John-Lluch/G6A-RISC/README.md

# G6A-RISC
G6A-RISC Relay based computer
