John-Lluch/G6A-RISC/Docs/OmronRelay/G6A-274.pdf

●Maximum Switching Power | ●Durability

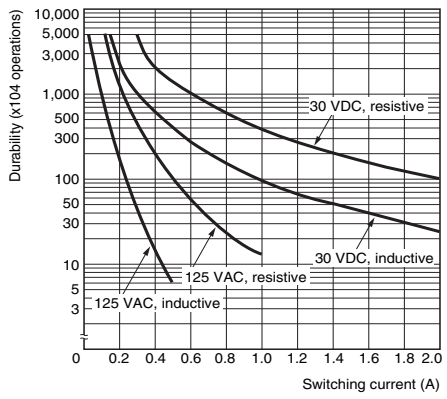
[picture p1: figure]
Durability (x104 operations); Switching current (A); 125 VAC, resistive; 125 VAC, inductive; 30 VDC, inductive; 30 VDC, resistive

0 | 0.2 0.4 0.6 0.8 1.0 1.2 1.4 1.6 1.8 2.0
