John-Lluch/G6A-RISC/Docs/OmronRelay/G6A-274_.pdf

●Electrical Durability Test *1 | ●Contact Reliability Test *1, *2

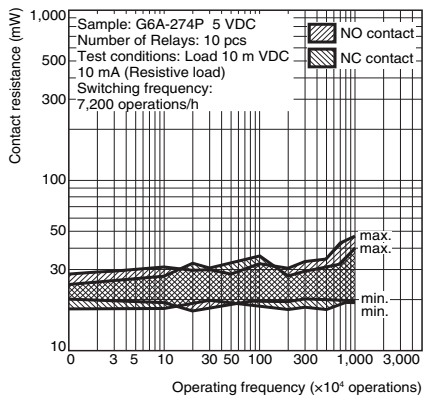
[picture p2: figure]
NO contact; NC contact; Sample: G6A-274P; 5 VDC; Number of Relays: 10 pcs Test conditions: Load 10 m VDC 10 mA (Resistive load) Switching frequency: 7,200 operations/h; max.; min.; Operating frequency (×10⁴; operations); Contact resistance (mW)
