John-Lluch/G6A-RISC/Docs/LogisimDocs/Buffer1.pdf

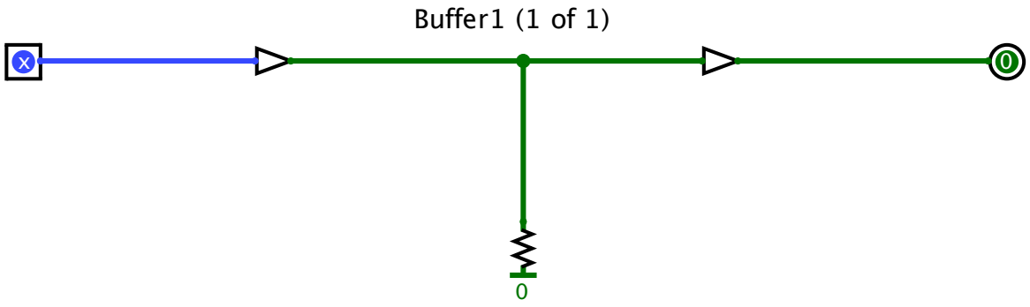
[picture p3: figure]
Buffer1 (1 of 1)
