John-Lluch/G6A-RISC/Docs/LogisimDocs/INCBase1.pdf

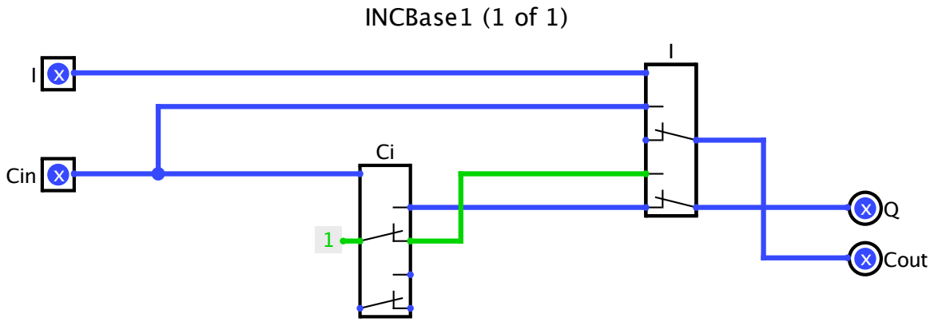
[picture p4: figure]
INCBase1 (1 of 1); Cin; x Cout
