John-Lluch/G6A-RISC/Docs/OmronRelay/G6A-274.png

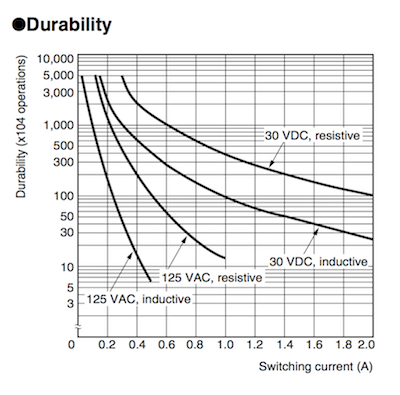
Docs/OmronRelay/G6A-274.png
