John-Lluch/G6A-RISC/Docs/OmronRelay/G6A-274_.png

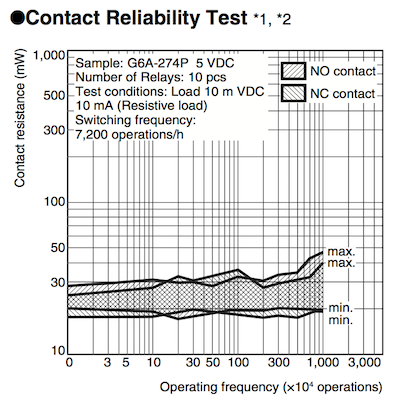
Docs/OmronRelay/G6A-274_.png
