John-Lluch/G6A-RISC/Docs/Sequencer.png

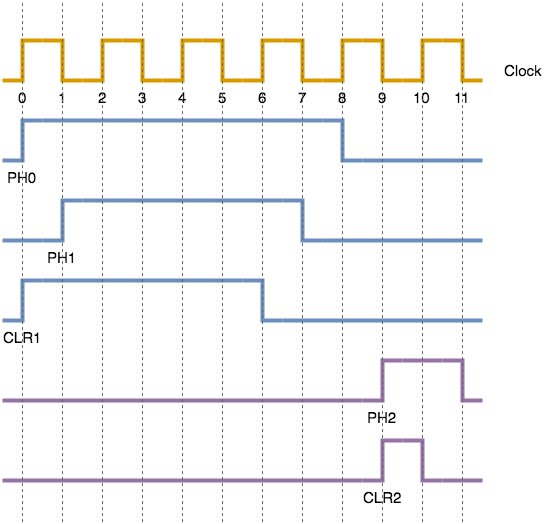
Docs/Sequencer.png
