John-Lluch/G6A-RISC/Docs/LogisimDocs/ALUFlags.pdf

# ALUFlags (1 of 1)

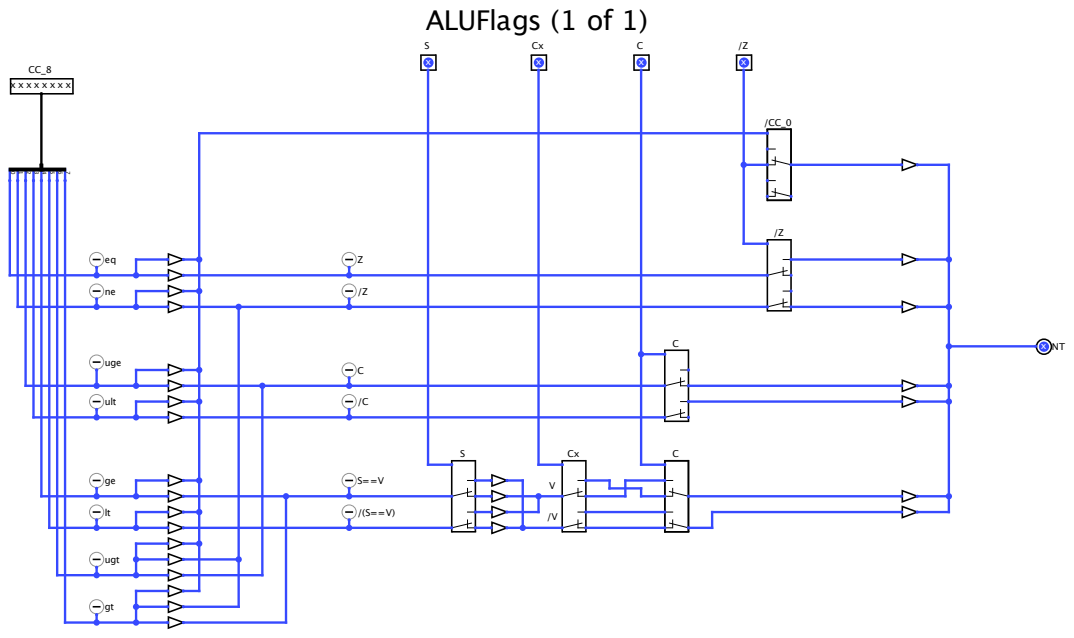
[picture p8: page 1]
ugt; ult; uge
