John-Lluch/G6A-RISC/Docs/LogisimDocs/ALU16Bit.pdf

# ALU16Bit (1 of 1)

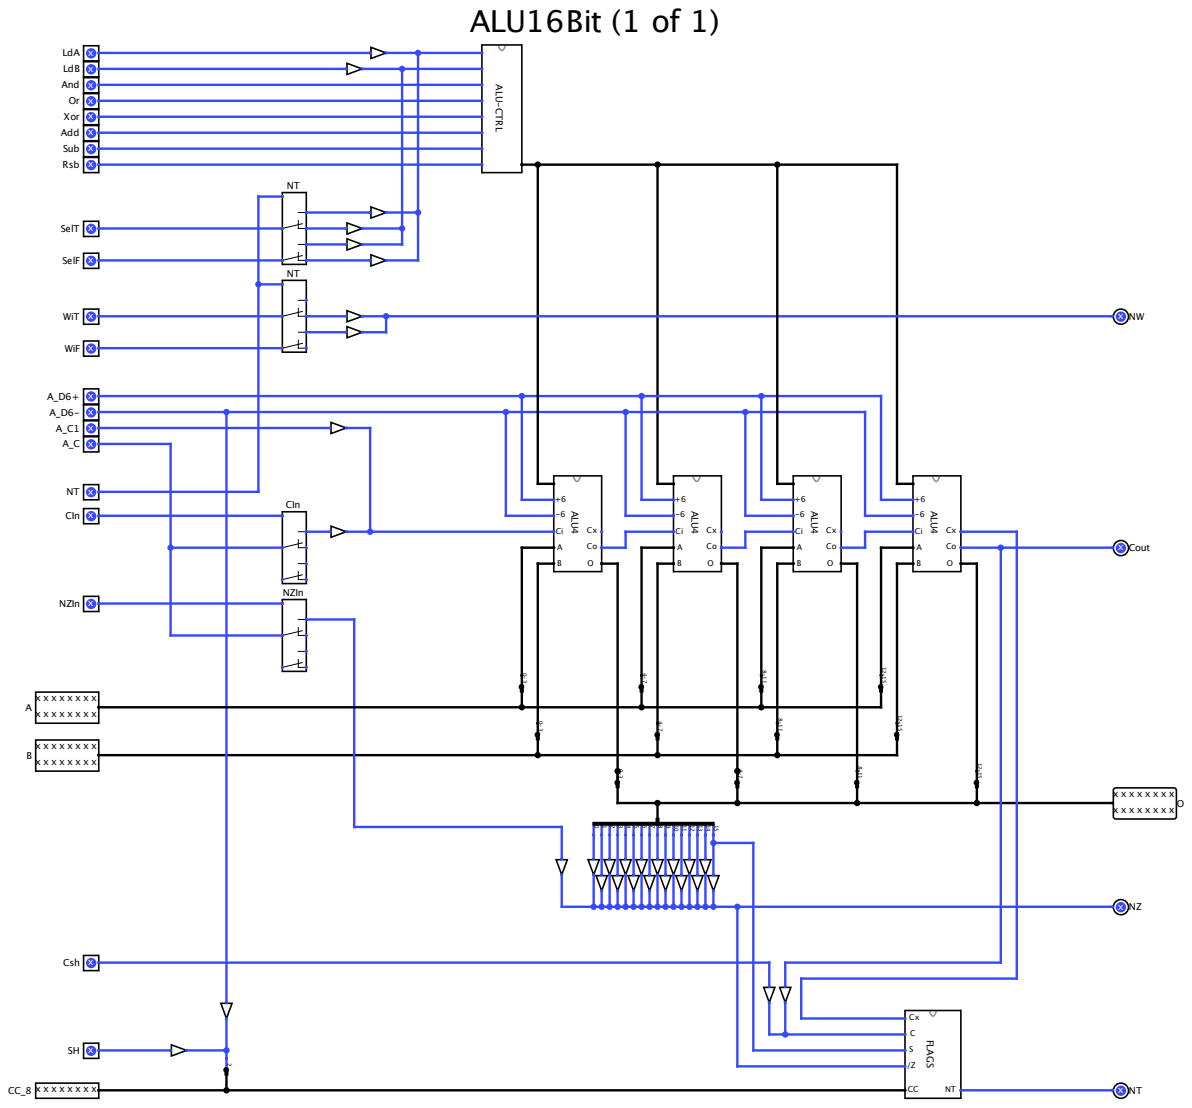
[picture p9: page 1]
Add; SelT; SelF; ALU4; FLAGS; Sub; WiT; CIn; ALU-CTRL; NZIn; x Cout; Csh; WiF; Rsb; LdB; And; LdA; Xor
