John-Lluch/G6A-RISC/Docs/LogisimDocs/InstDecoder.pdf

# InstDecoder (1 of 1)

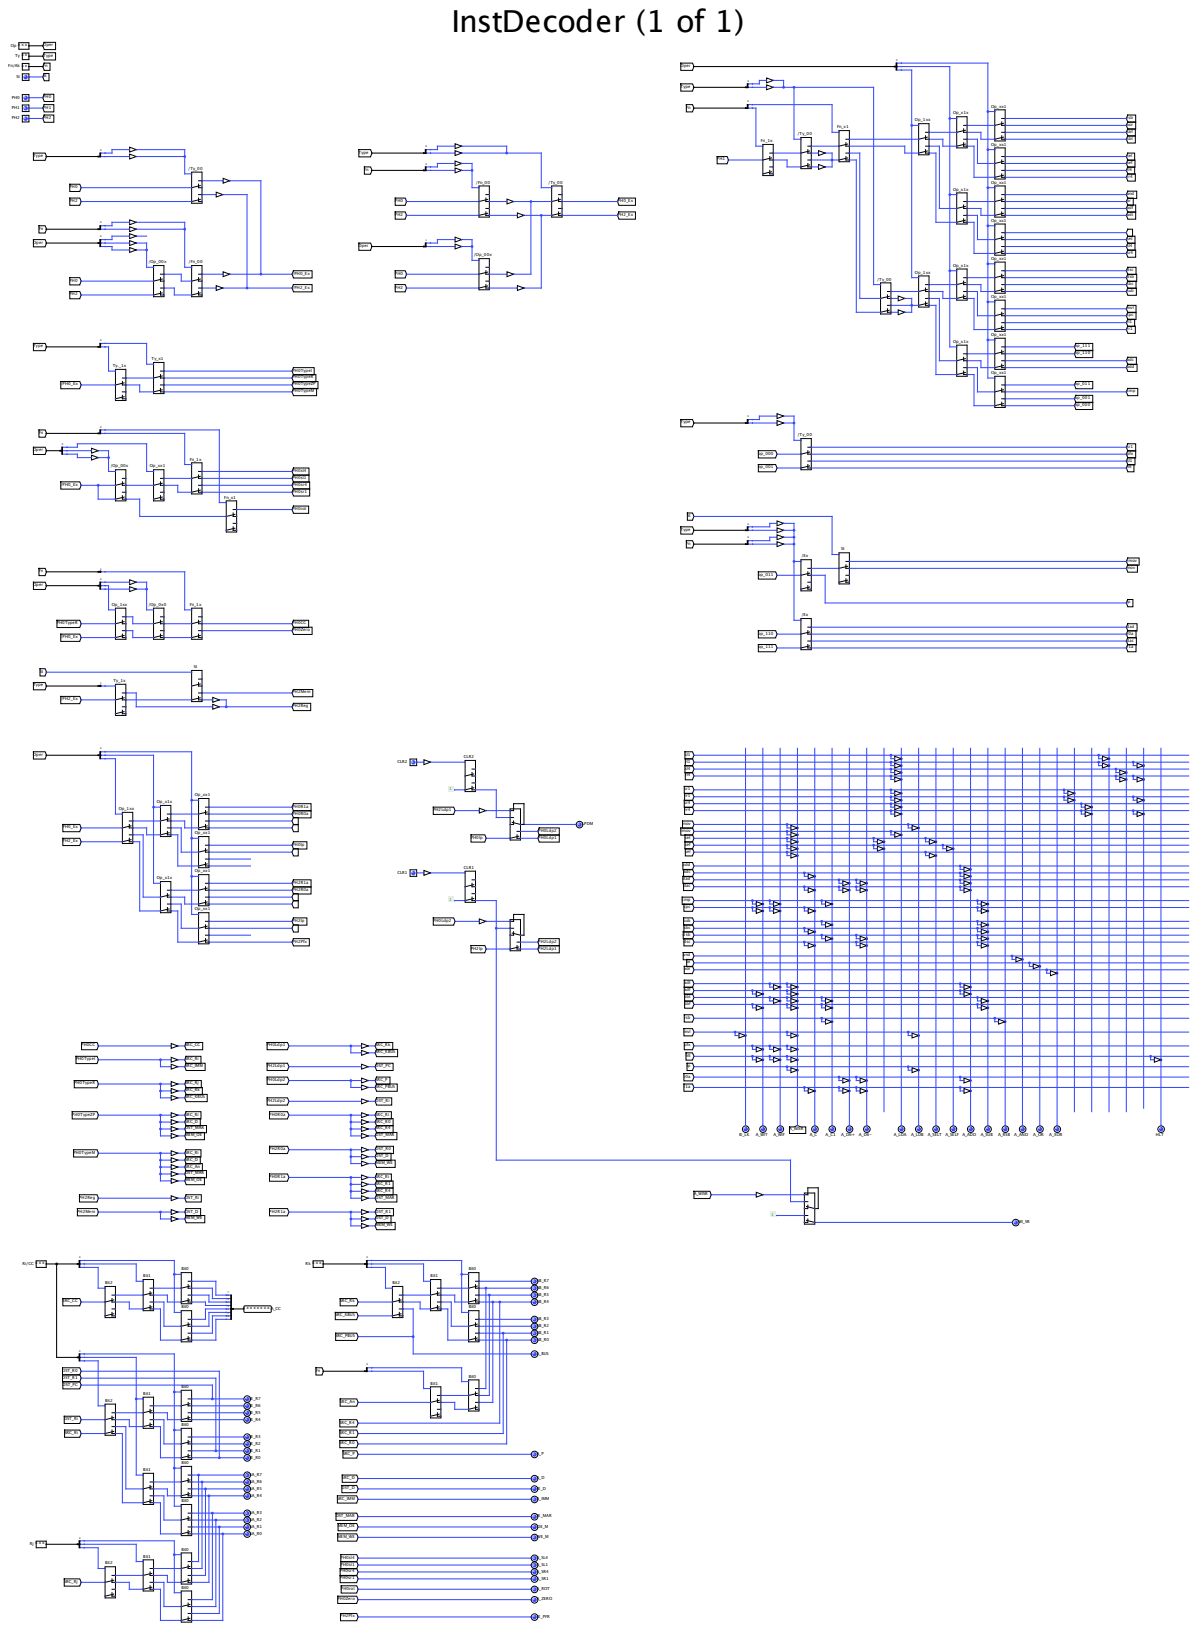
[picture p10: page 1]
Type; Bit2; Bit1; DST_Ri; sub; SRC_R0; Bit0; mvl; rmov; DST_MAR; PH0Zero; and; A_ADD; PH2Ldp2; rsb; add; A_WISR; PH0rot; PH0Ldp2; MEM_WE; dsc; DST_R0; CLR1 x; SRC_Ri; pfx; SRC_D; dsb; PH2Pfx; adf; SRC_Rk; x S_BUS; SRC_IMM; DST_PC; A_RSB; x LPDM; adc; sel; SRC_P; dac; SRC_CC; CLR2 x; SRC_R1; PH0TypeI; PH2Mem; x IE_PFR; PH2Ldp1; PH0TypeR; sbc; cmp; hlt; cpc; SRC_An; PH0TypeZP; adt; x IE_MAR; PH0TypeM; DST_D; SRC_PBUS; SRC_R4; Oper; x S_ZERO; x S_ROT; xor; DST_R1; CLR1; A_LDA; dad; PH0Ldp1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
