John-Lluch/G6A-RISC/Docs/LogisimDocs/ALUBase1Bit.pdf

## ALUBase1Bit (1 of 1)

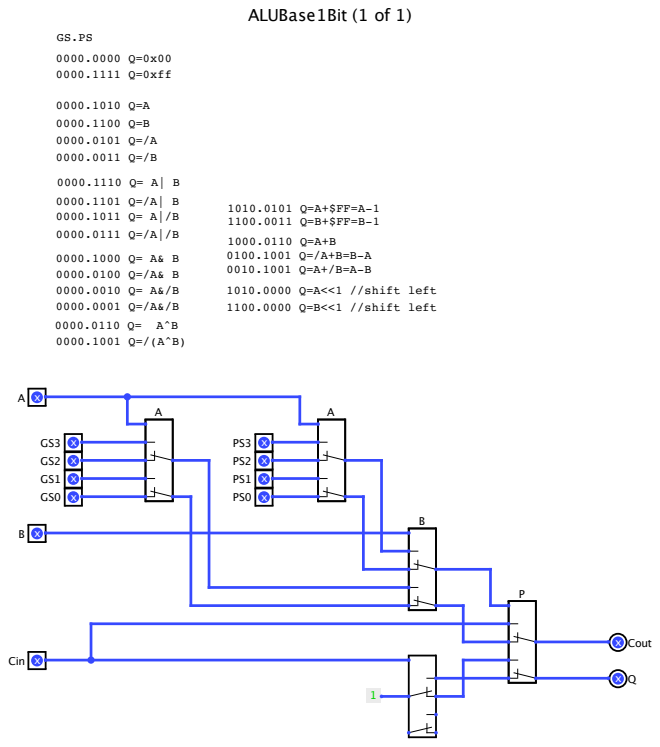
[picture p11: page 1]
0000.1111 Q=0xff; 1100.0000 Q=B<<1 //shift left; Cin; 1010.0000 Q=A<<1 //shift left; x Cout
