John-Lluch/G6A-RISC/Docs/LogisimDocs/ALUBase4Bit.pdf

ALUBase4Bit (1 of 1) Op | x x x x x x x x | ALU-1 | ALU-1

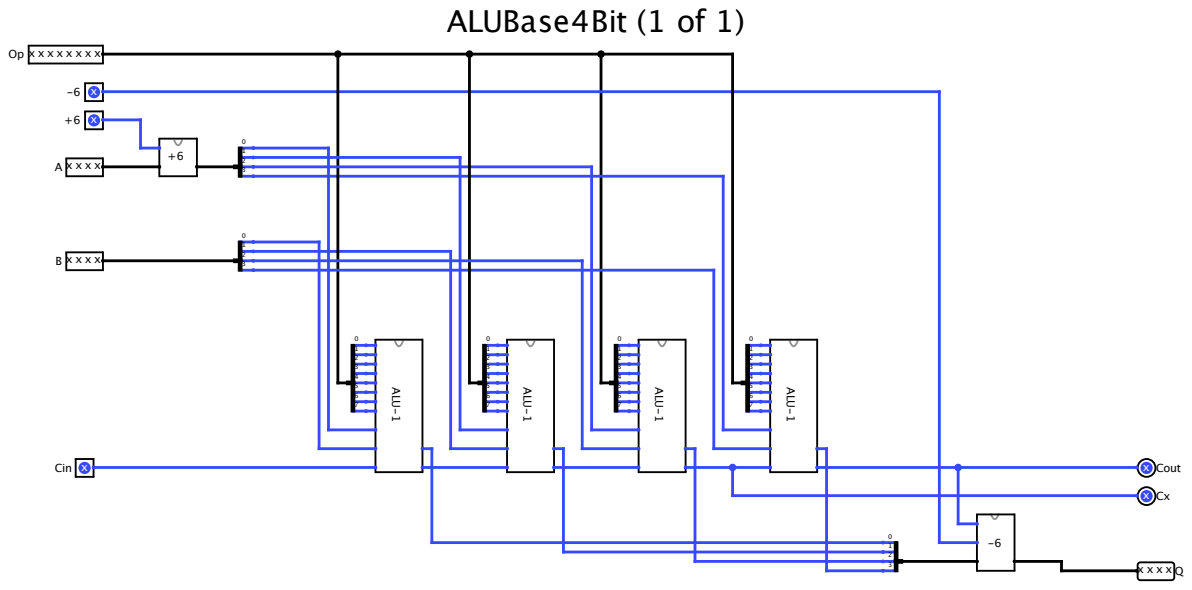
[picture p12: page 1]
ALU-1; Cin; x Cout
