John-Lluch/G6A-RISC/Docs/LogisimDocs/ALUSub6.pdf

ALUSub6 (1 of 1) | 0

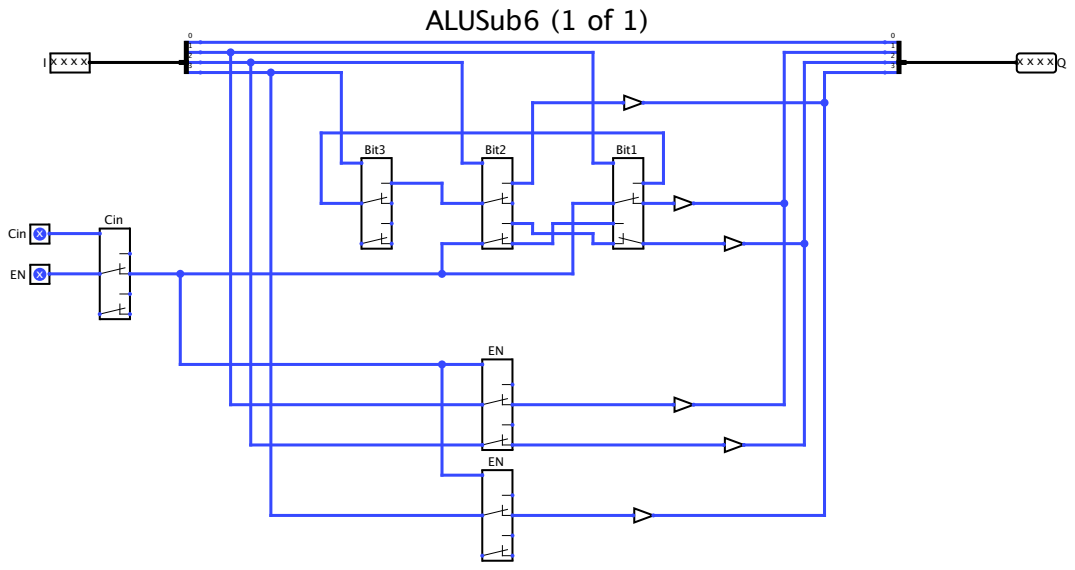
[picture p13: page 1]
Bit1; Cin; Bit3; Bit2
