John-Lluch/G6A-RISC/Docs/LogisimDocs/Main.pdf

# Main (1 of 1)

# R Out ALU REG ALUR

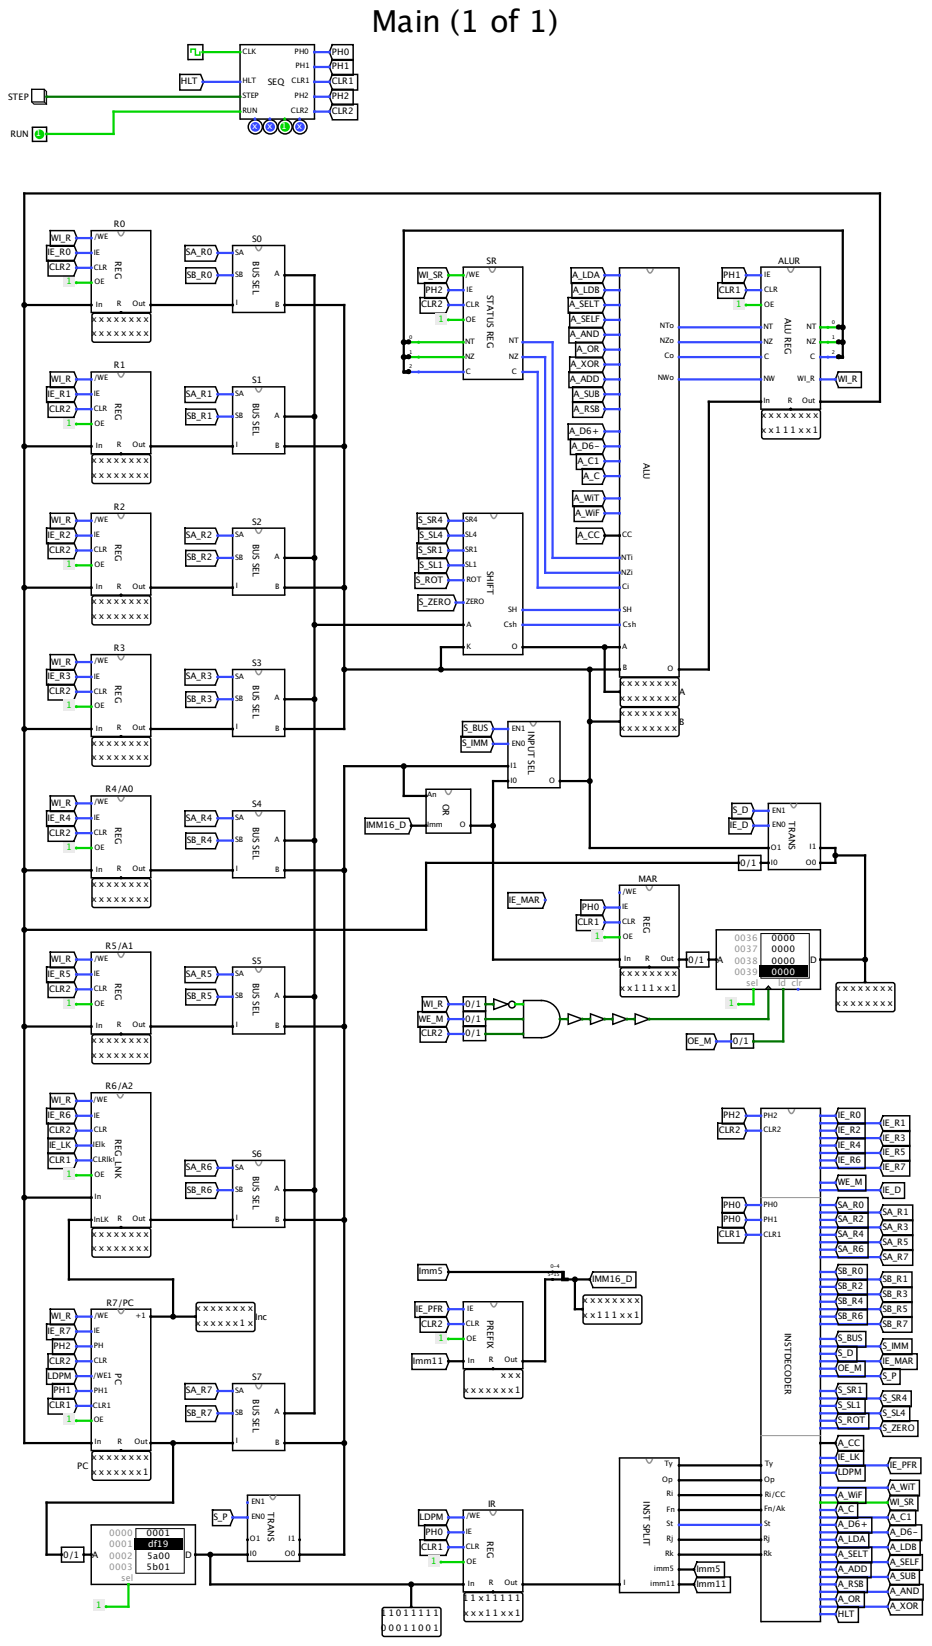
[picture p14: page 1]
HLT; CLR2; Csh; ZERO; ROT; SHIFT; IE_MAR; Imm5; BUS SEL S5; imm5; imm11; INST SPLIT; A_LDA; A_SUB; CLR1; sel; ld clr; O0 TRANS; Imm11; A_AND; S_ROT; A_WiT; RUN; A_SELT; LDPM; BUS SEL S0; S_IMM; A_XOR; STEP; CLR; Out; REG; REG R0; NZo; NZi; NTo; NTi; NWo; ALU; Imm; REG R1; REG R2; REG MAR; InLK; CLRlk; IElk; REG_LNK; A_WiF; A_ADD; Inc x x x x x x1 x; PREFIX; A_RSB; S_ZERO; A_SELF; A_LDB; BUS SEL S7; BUS SEL S1; BUS SEL S2; IE_PFR; STATUS REG SR; INPUT SEL; REG IR; BUS SEL S3; BUS SEL S6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
