John-Lluch/G6A-RISC/Docs/LogisimDocs/ADD16.pdf

# ADD16 (1 of 1)

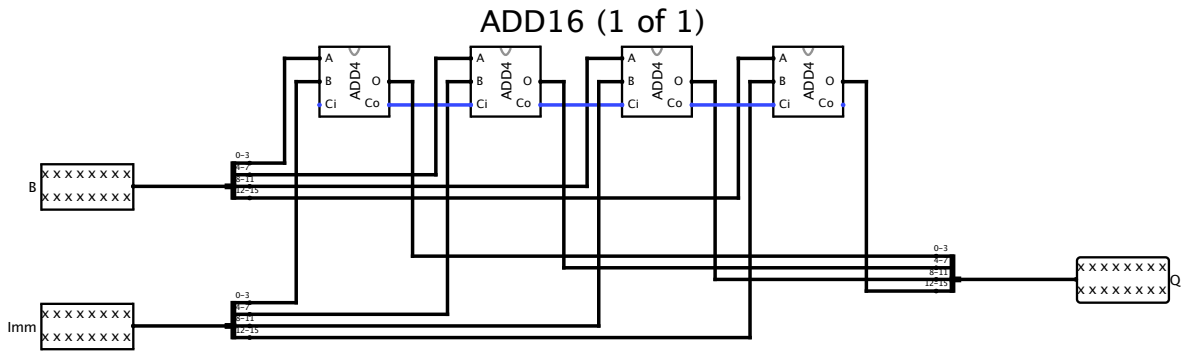
[picture p15: page 1]
Imm; Co ADD⁴

8-11
12-15

4-7
