John-Lluch/G6A-RISC/Docs/LogisimDocs/ADDBase1Bit.pdf

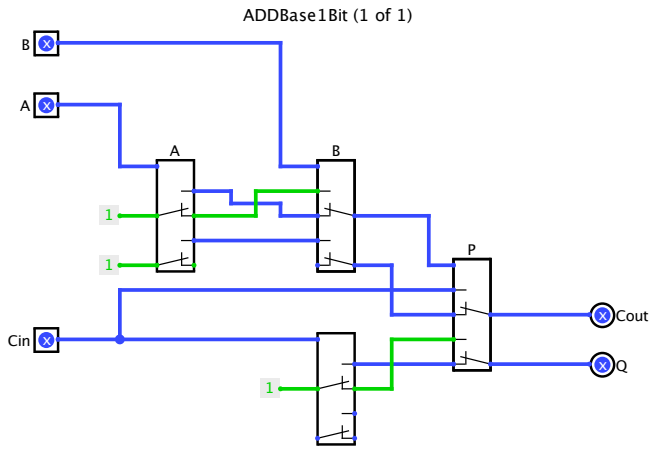
[picture p16: page 1]
ADDBase1Bit (1 of 1); Cin; x Cout
