John-Lluch/G6A-RISC/Docs/LogisimDocs/ALUAdd6.pdf

# ALUAdd6 (1 of 1)

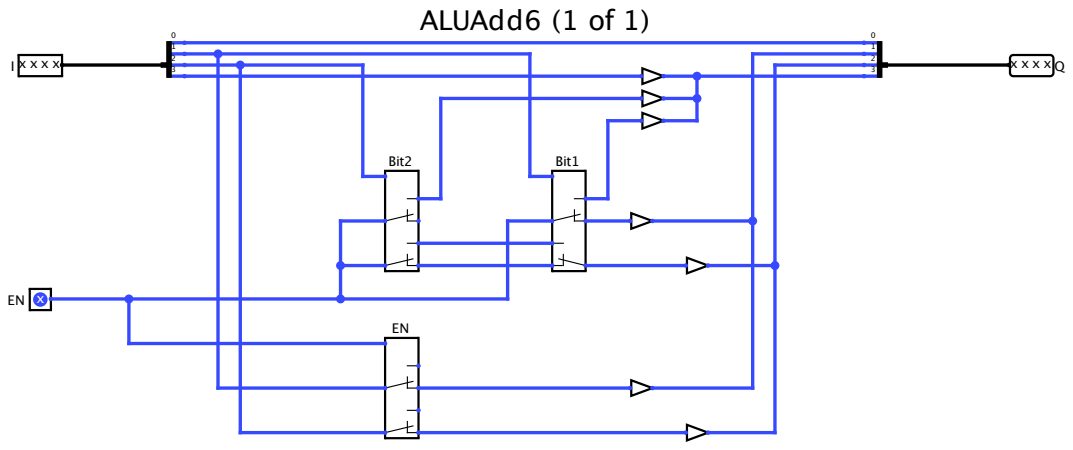
[picture p17: page 1]
Bit2; Bit1
