John-Lluch/G6A-RISC/Docs/LogisimDocs/ALUController.pdf

# ALUController (1 of 1)

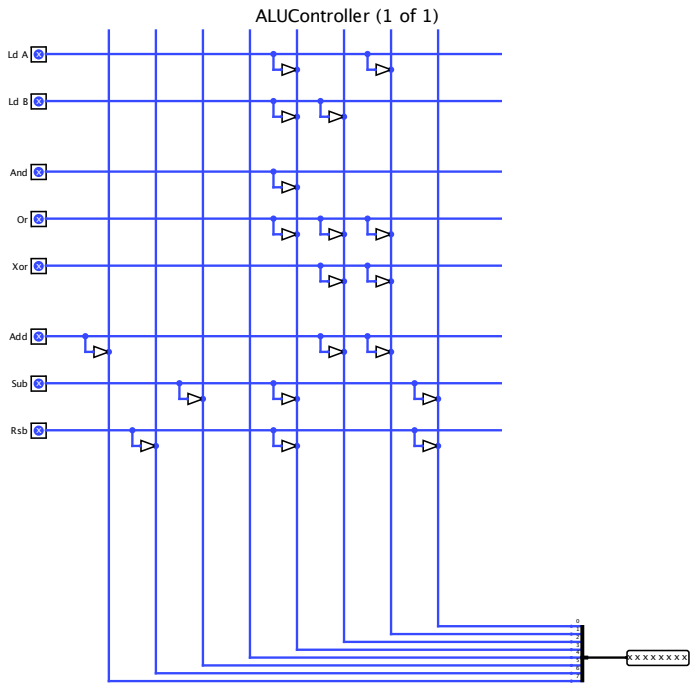
[picture p18: page 1]
Add; Sub; And; Rsb; Xor
