John-Lluch/G6A-RISC/Docs/LogisimDocs/Buffer16.pdf

## Buffer16 (1 of 1)

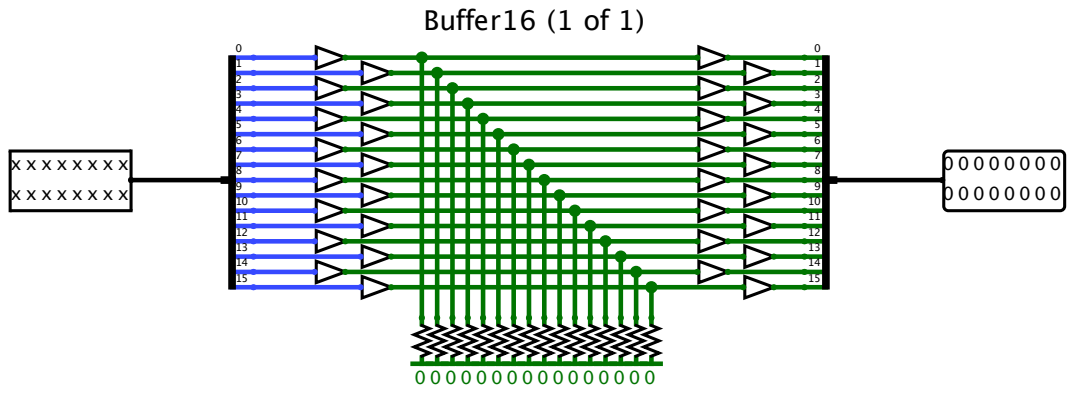
[picture p19: page 1]
