John-Lluch/G6A-RISC/Docs/LogisimDocs/BusSelect.pdf

# BusSelect (1 of 1)

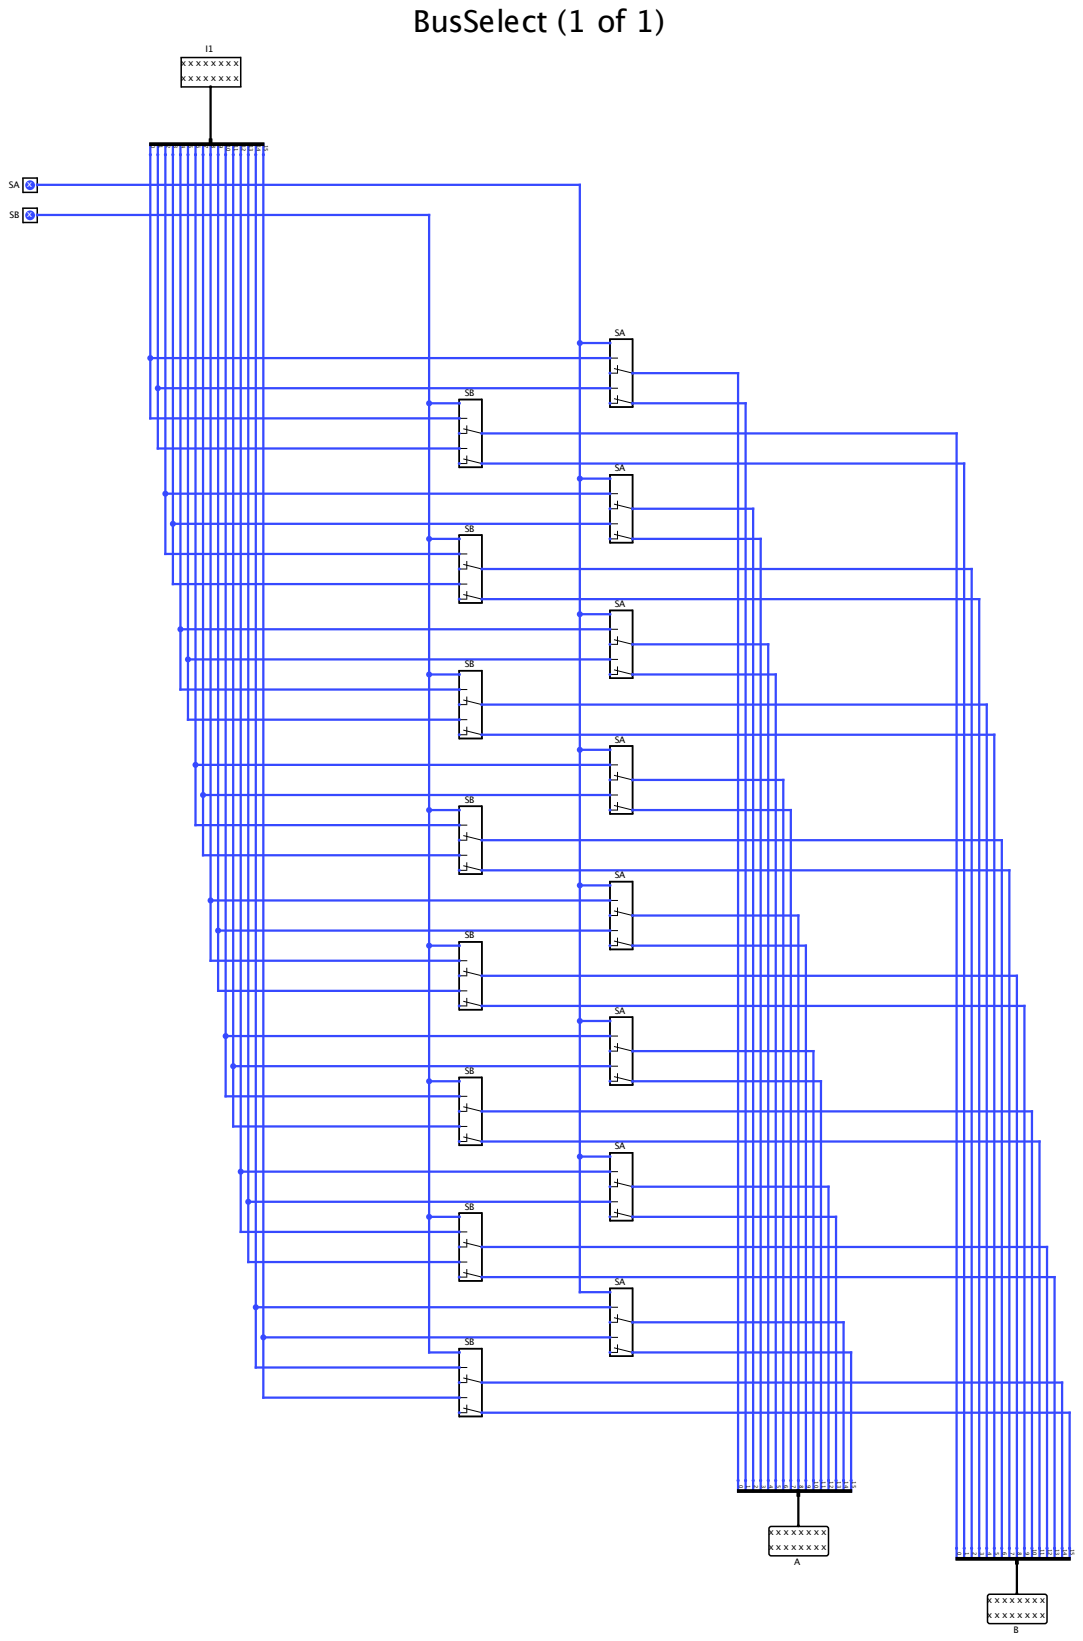
[picture p20: page 1]
