John-Lluch/G6A-RISC/Docs/LogisimDocs/INCrementer.pdf

# INCrementer (1 of 1)

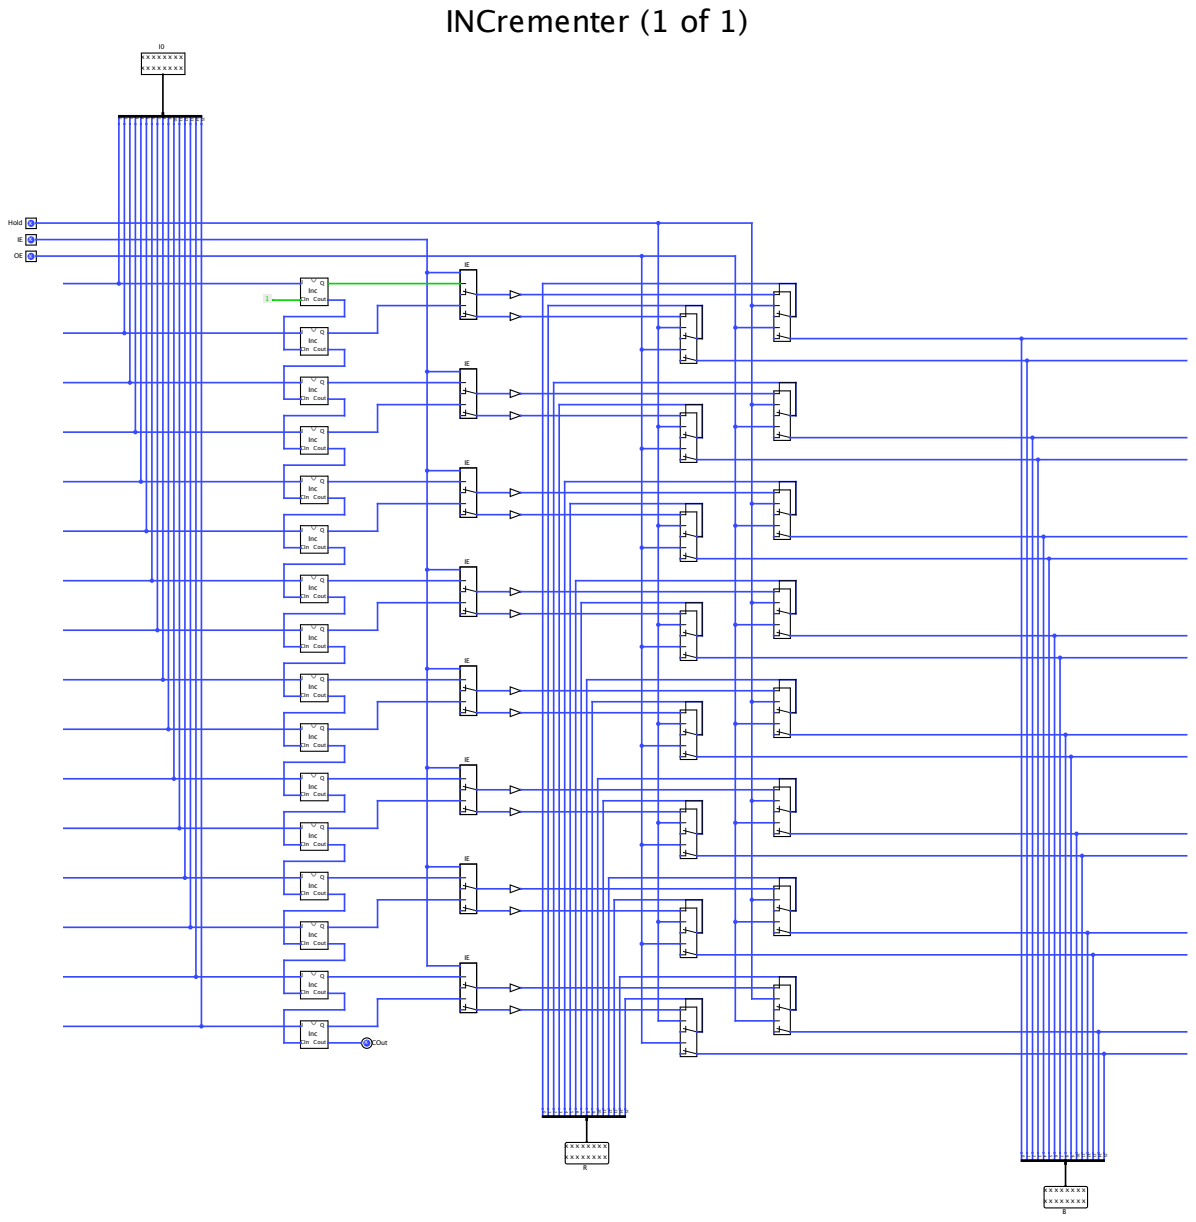
[picture p21: page 1]
Inc; CIn Cout; Hold x; x COut
