John-Lluch/G6A-RISC/Docs/LogisimDocs/InputSelect.pdf

# InputSelect (1 of 1)

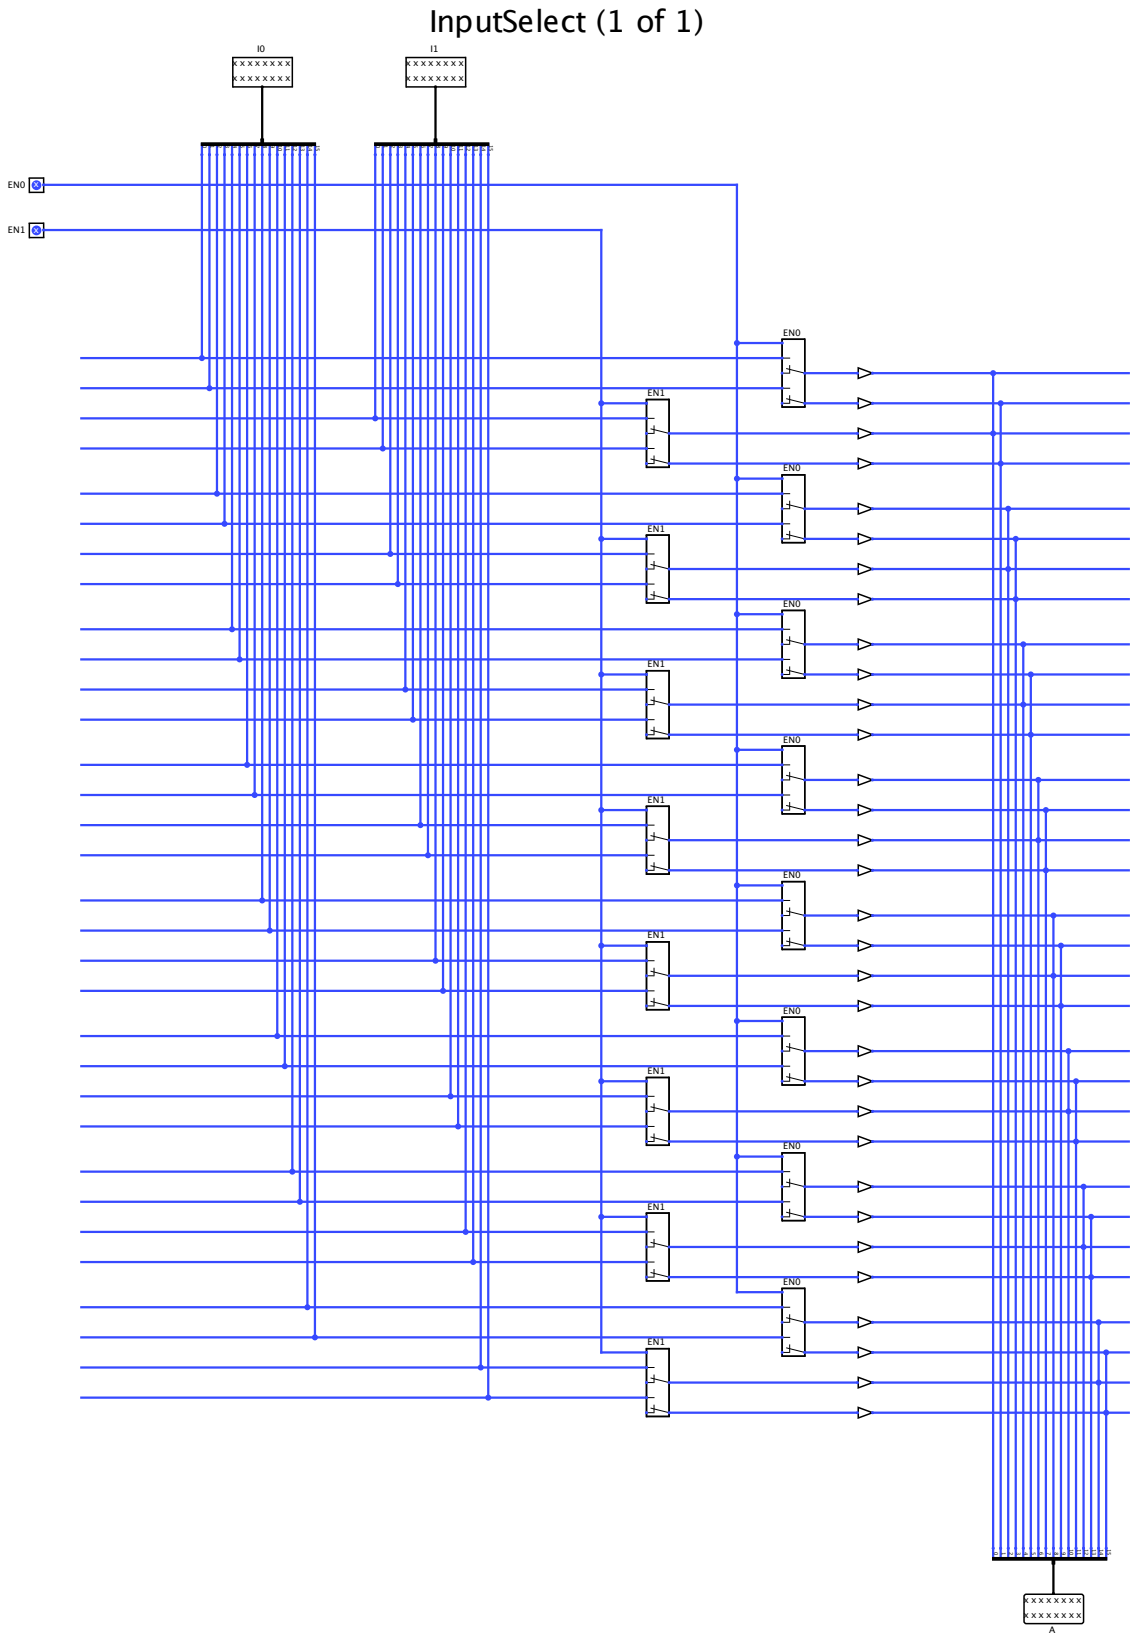
[picture p22: page 1]
