John-Lluch/G6A-RISC/Docs/LogisimDocs/InputSwitch.pdf

# InputSwitch (1 of 1)

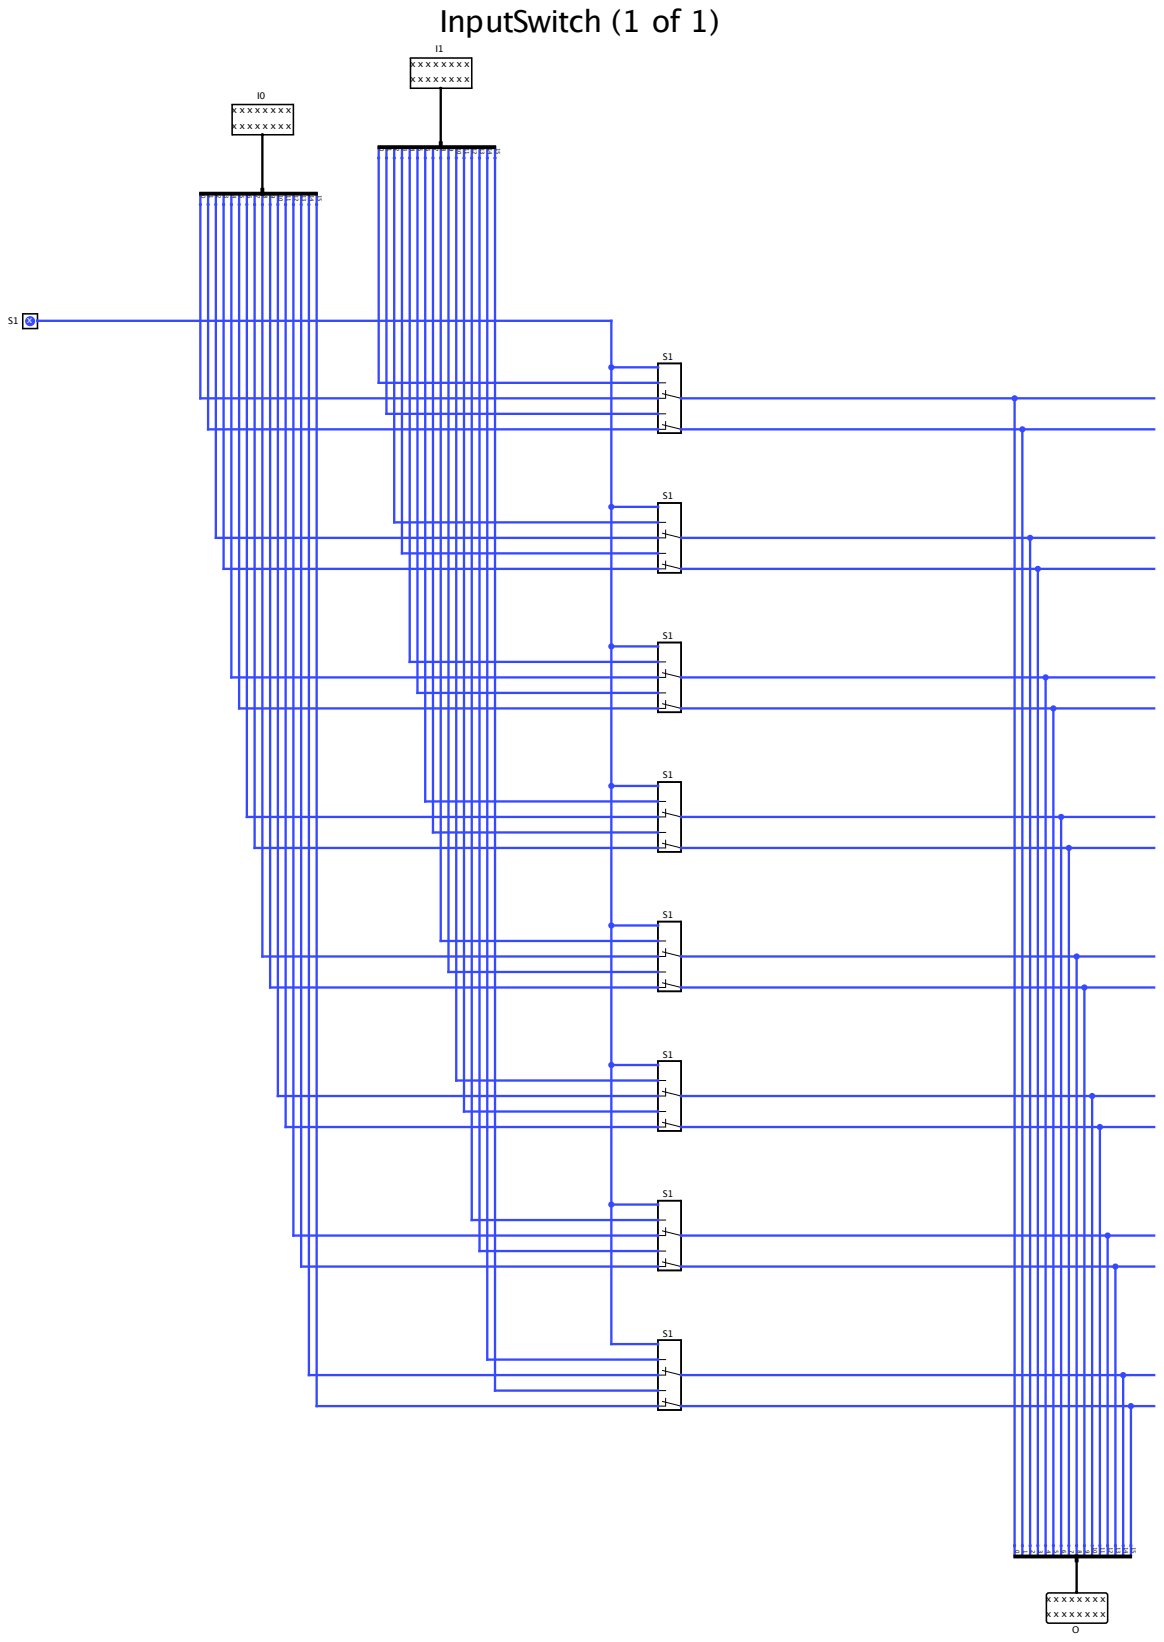
[picture p23: page 1]
