John-Lluch/G6A-RISC/Docs/LogisimDocs/InstFieldDecoder.pdf

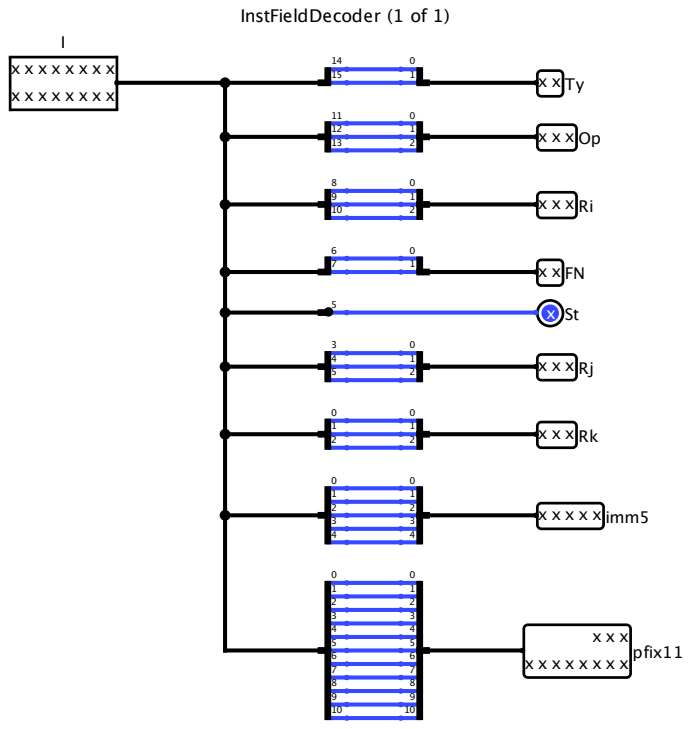
[picture p24: page 1]
InstFieldDecoder (1 of 1); pfix11 x x x x x x x x; x x x x x imm5
