John-Lluch/G6A-RISC/Docs/LogisimDocs/REG16Bit.pdf

## REG16bit (1 of 1)

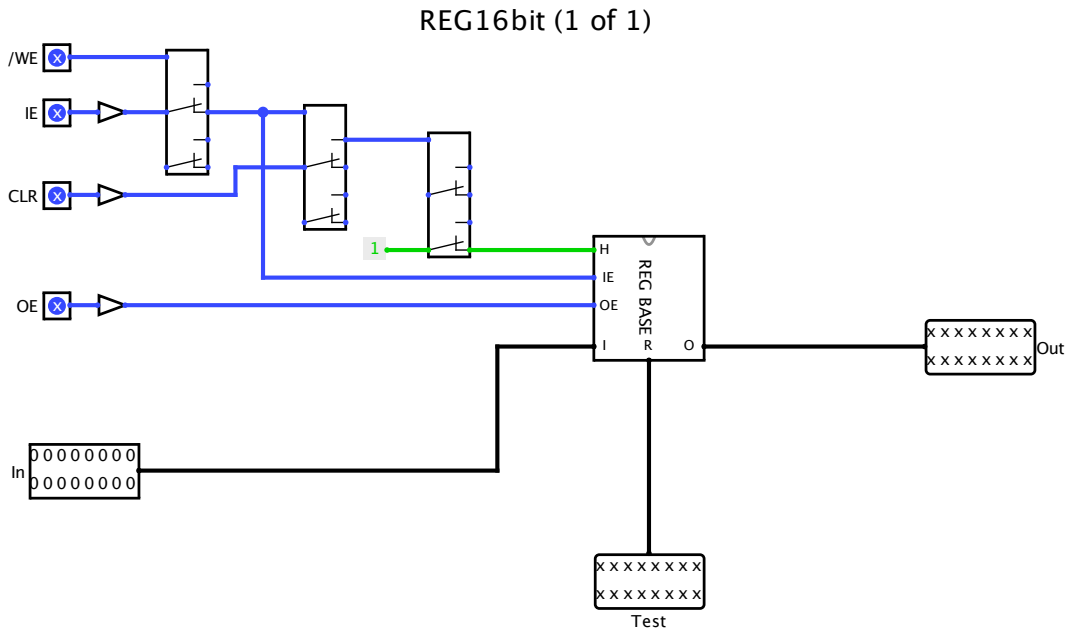
[picture p25: page 1]
CLR; O REG BASE; Out x x x x x x x x; Test
