John-Lluch/G6A-RISC/Docs/LogisimDocs/REG_ALU.pdf

# REG_ALU (1 of 1)

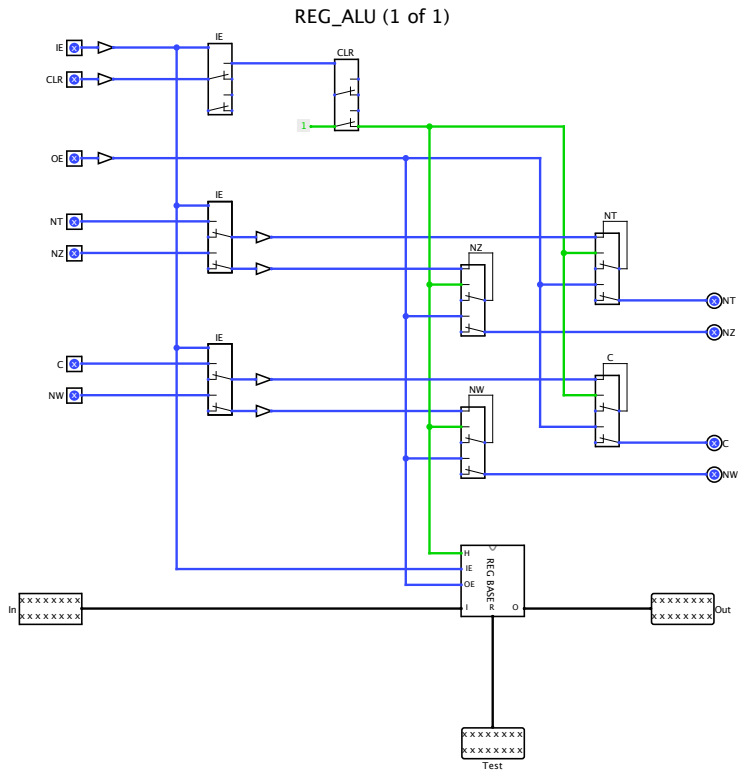
[picture p26: page 1]
Out x x x x x x x x; Test; CLR; O REG BASE
