John-Lluch/G6A-RISC/Docs/LogisimDocs/REG_LINK.pdf

## REG_LINK (1 of 1)

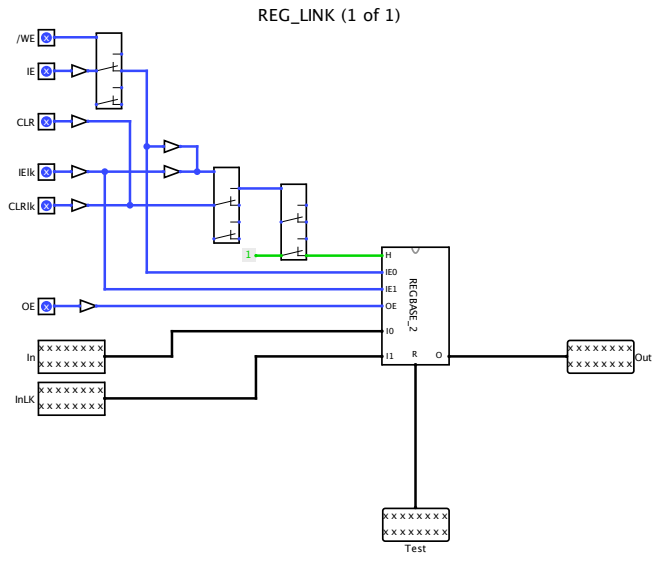
[picture p27: page 1]
Out x x x x x x x x; Test; CLR; CLRlk; REGBASE_2; InLK x x x x x x x x; IElk
