John-Lluch/G6A-RISC/Docs/LogisimDocs/REG_PC.pdf

# REG_PC (1 of 1)

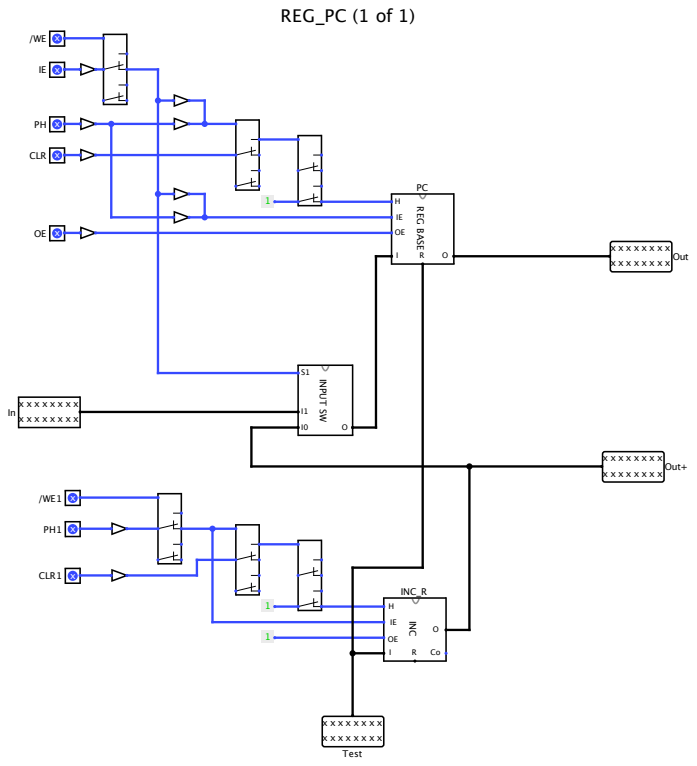
[picture p28: page 1]
INPUT SW; Out x x x x x x x x; CLR1; INC; INC_R; Test; O REG BASE; Out+ x x x x x x x x; CLR
