John-Lluch/G6A-RISC/Docs/LogisimDocs/REG_PFIX.pdf

## REG_PFIX (1 of 1)

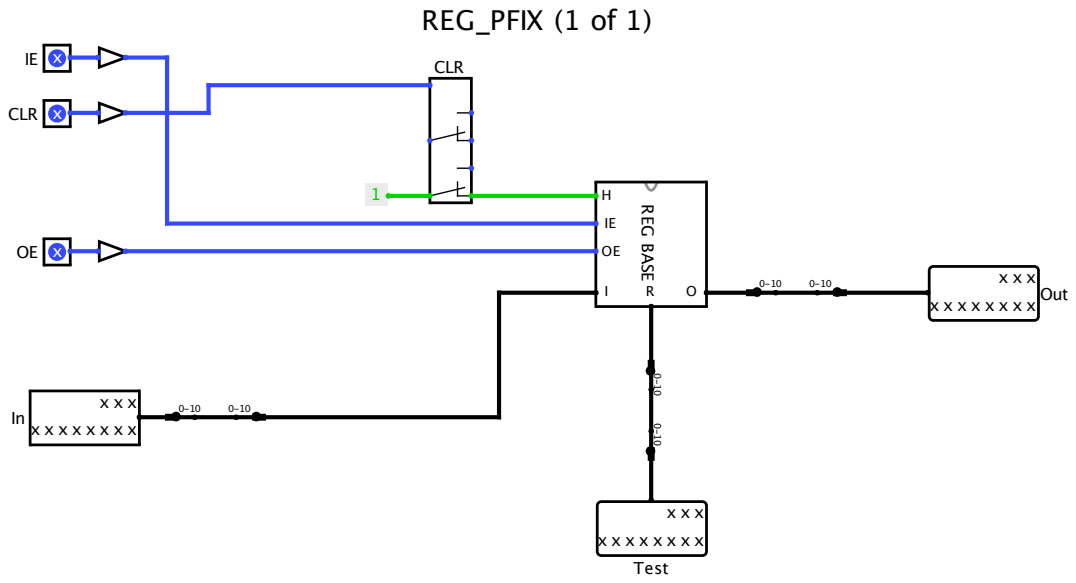
[picture p29: page 1]
O REG BASE; CLR; Test; Out x x x x x x x x
