John-Lluch/G6A-RISC/Docs/LogisimDocs/REG_STATUS.pdf

# REG_STATUS (1 of 1)

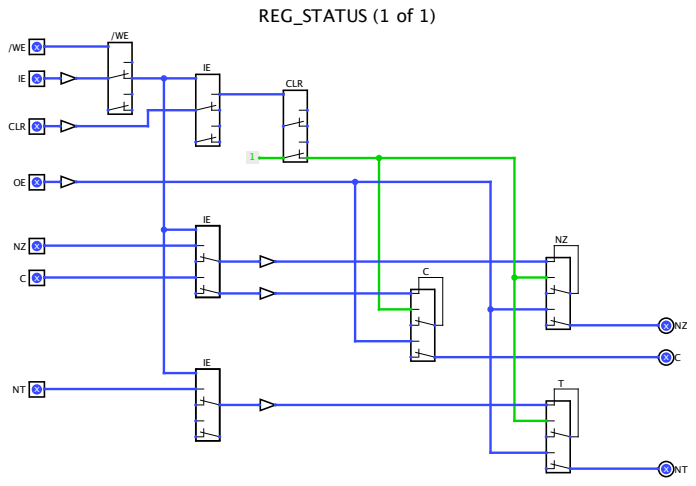
[picture p30: page 1]
CLR
