John-Lluch/G6A-RISC/Docs/LogisimDocs/REGBase16Bit.pdf

# REGBase16bit (1 of 1)

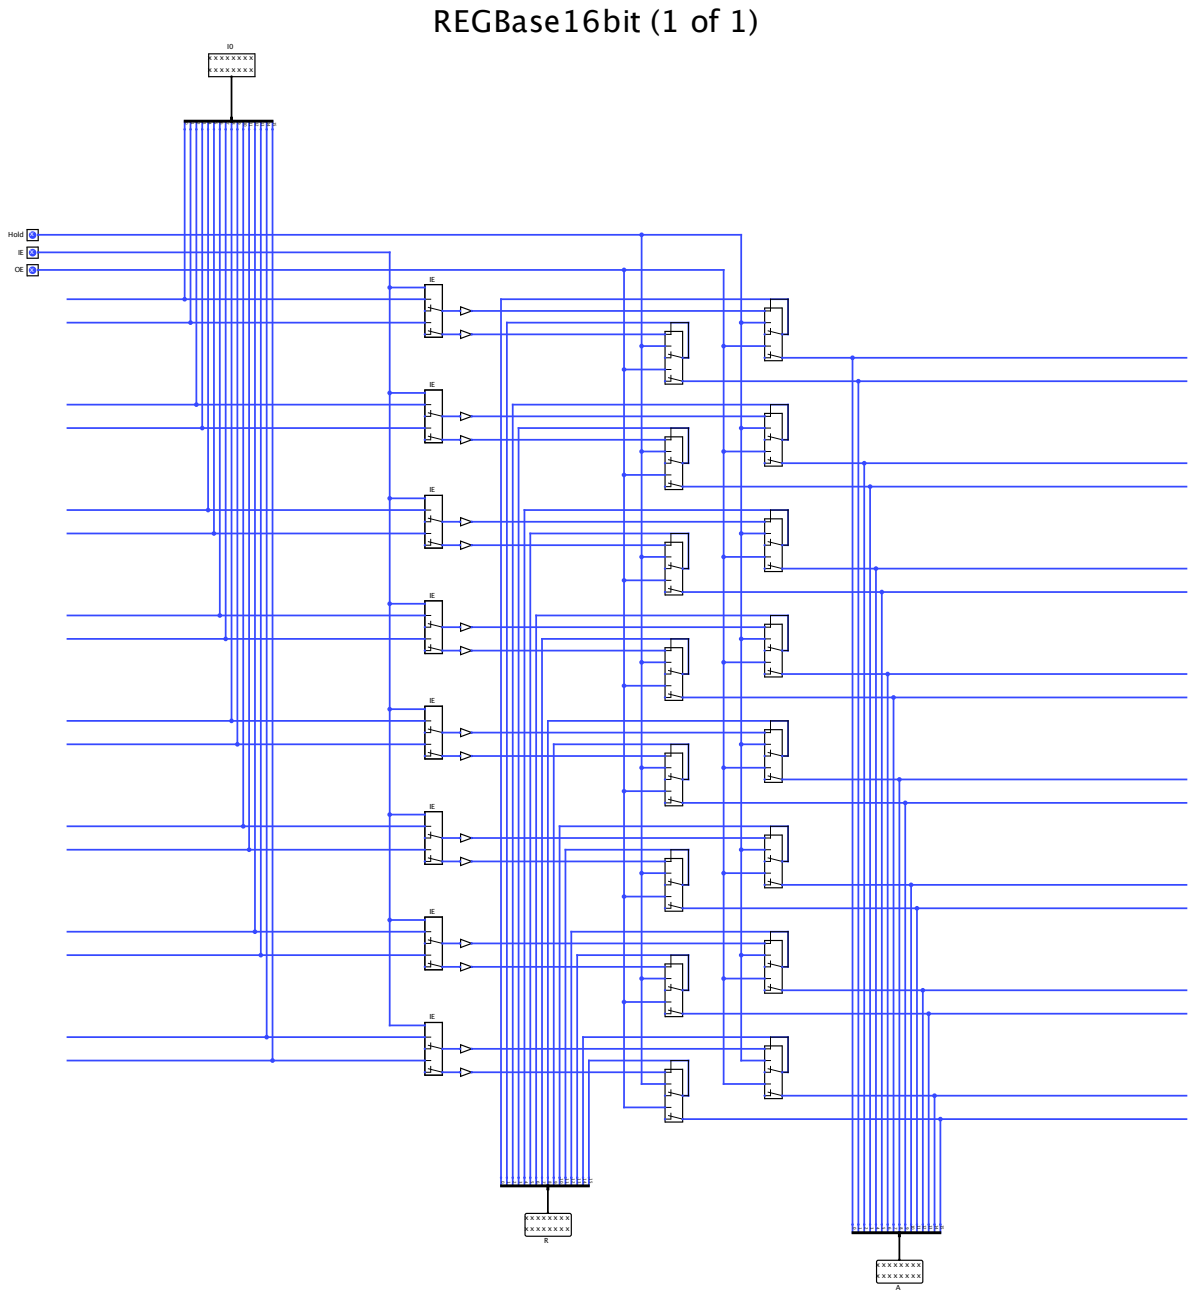
[picture p31: page 1]
Hold
