John-Lluch/G6A-RISC/Docs/LogisimDocs/REGBase16Bit_2.pdf

# REGBase16bit_2 (1 of 1) I0

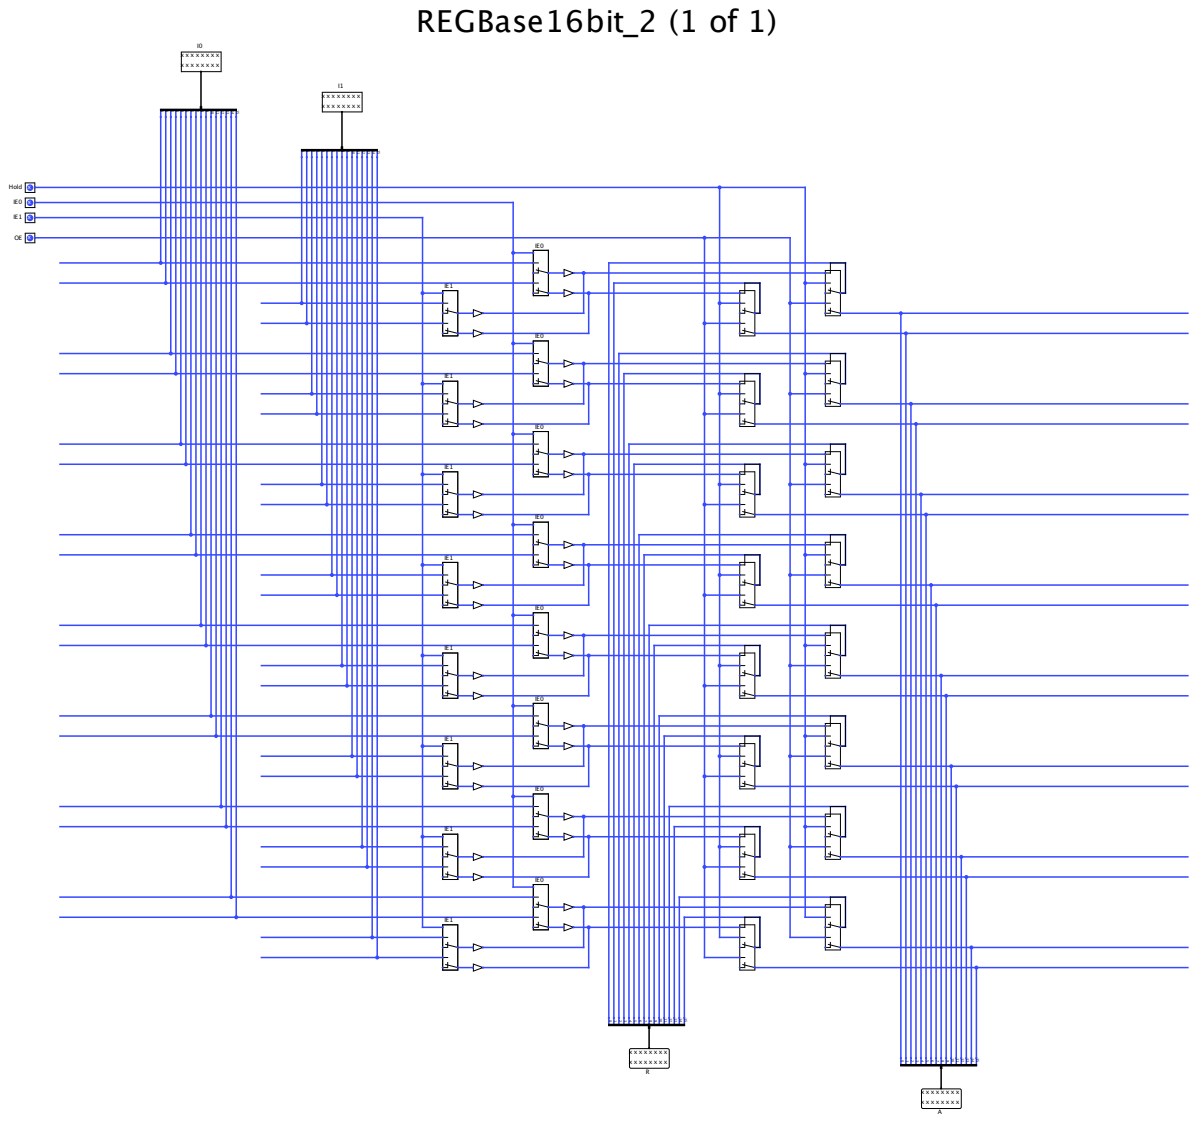
[picture p32: page 1]
Hold x
