John-Lluch/G6A-RISC/Docs/LogisimDocs/Sequencer.pdf

# Sequencer (1 of 1)

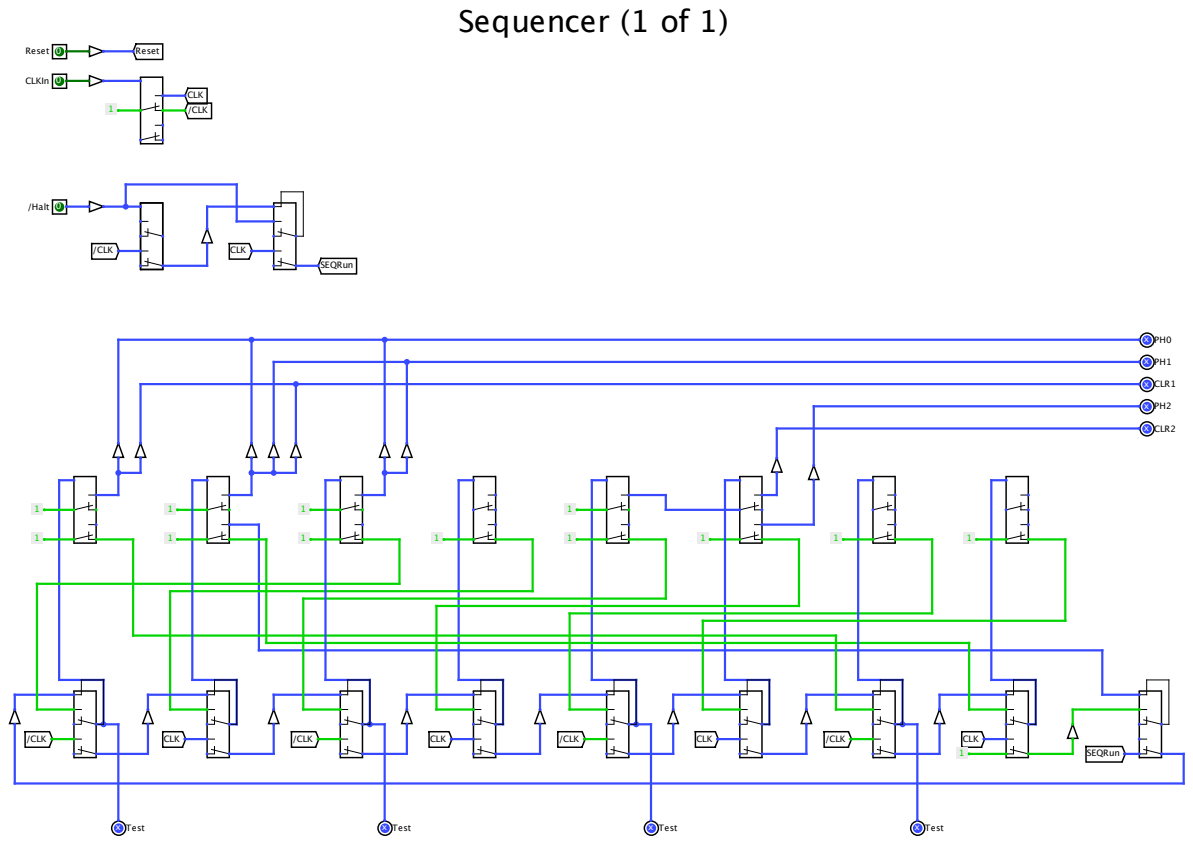
[picture p33: page 1]
/CLK; CLK; x CLR2; x Test; Reset; SEQRun; /Halt; x CLR1; CLKIn
