John-Lluch/G6A-RISC/Docs/LogisimDocs/SHIFT.pdf

# SHIFT (1 of 1)

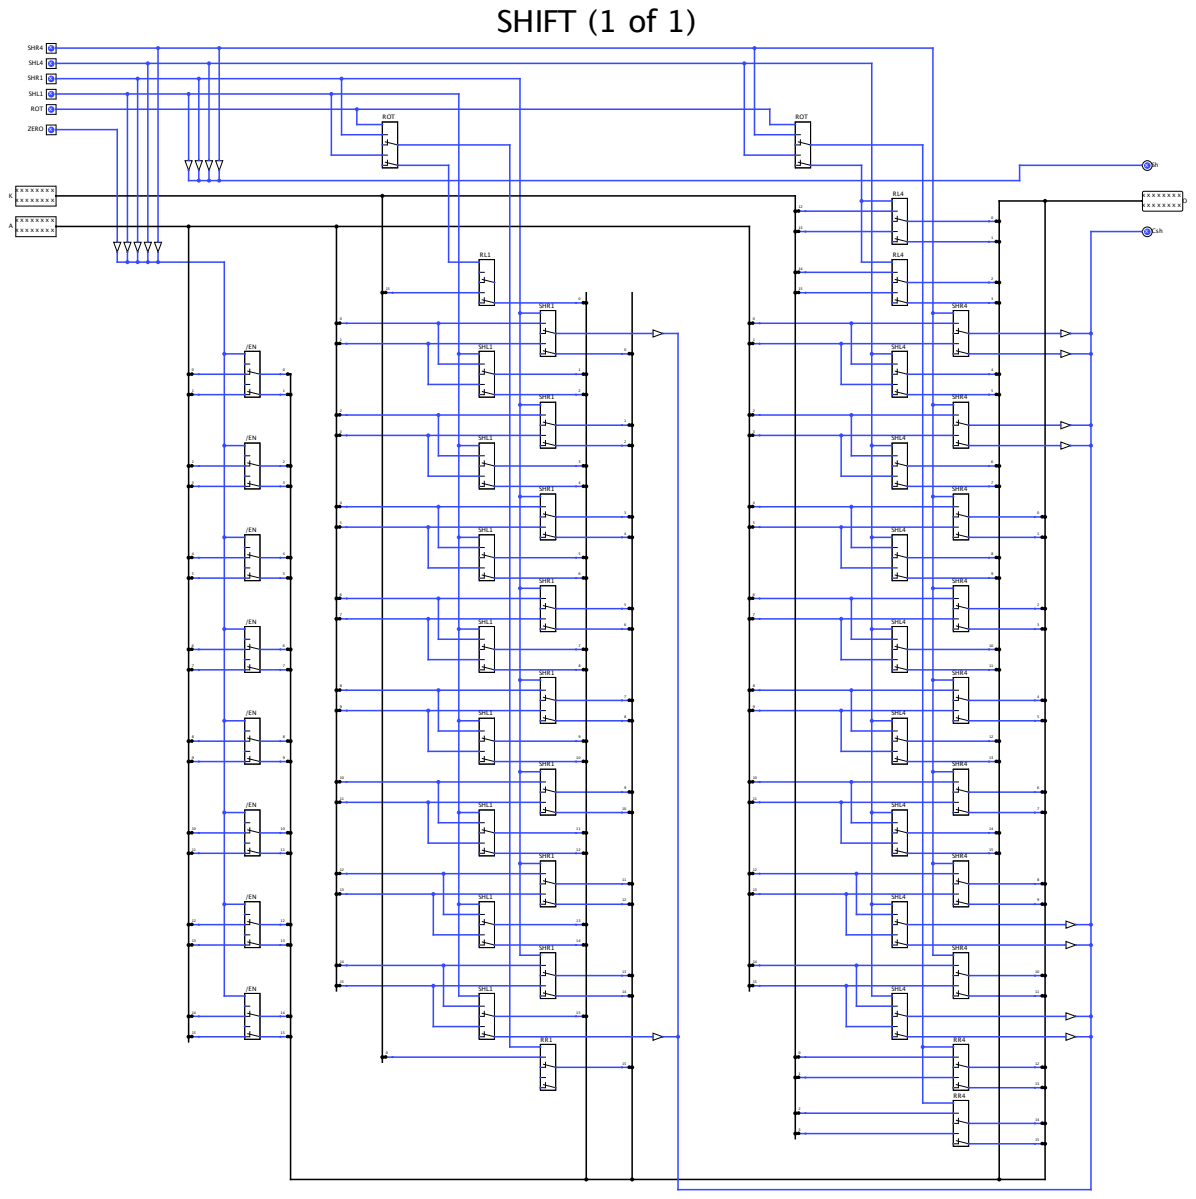
[picture p34: page 1]
SHL4; x Csh; SHL1; ROT; SHR4; SHR1; ZERO
