John-Lluch/G6A-RISC/Docs/LogisimDocs/Transceiver.pdf

# Transceiver (1 of 1)

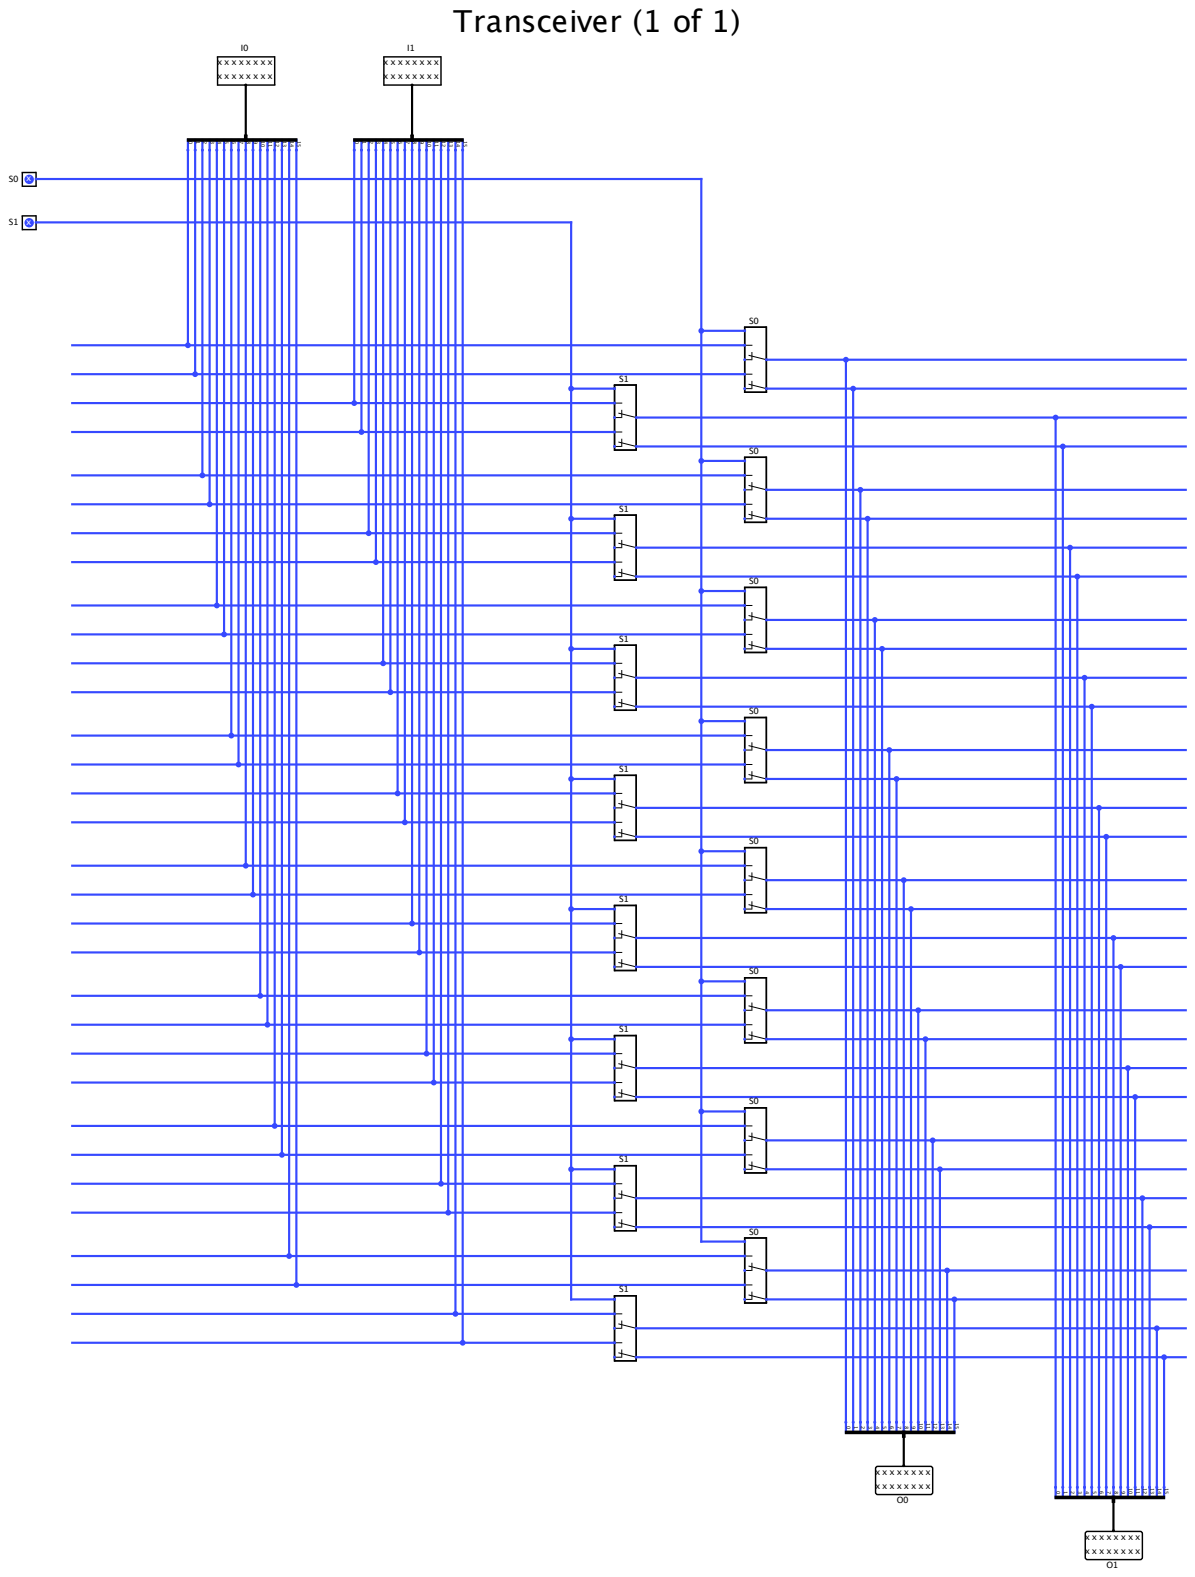
[picture p35: page 1]
