John-Lluch/G6A-RISC/(list of files, drawings)

Other design files:
Logisim/G6A-Risc.circ
LogisimBackup/G6A-Risc.circ
LogisimBackup/Llibreries/logi7400dip.circ
LogisimBackup/Llibreries/logi7400ic.circ
LogisimBackup/Llibreries/RELAYS.circ
